camiloVargasTechnaid/techstim-hardware/3DMODELS/EXG.0B.304.HLN/EPG.0B.306.HLN.stp

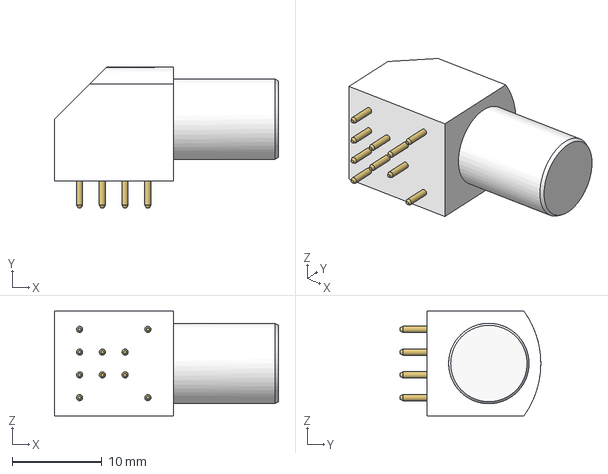
[picture p1: CAD file, 2024-04-24]
3DMODELS/EXG.0B.304.HLN/EPG.0B.306.HLN.stp
25.0 x 15.7 x 11.7 mm
