camiloVargasTechnaid/techstim-hardware/3DMODELS/EXG.1B.306.LLNZ/EXP.1S.306.HLNS.stp

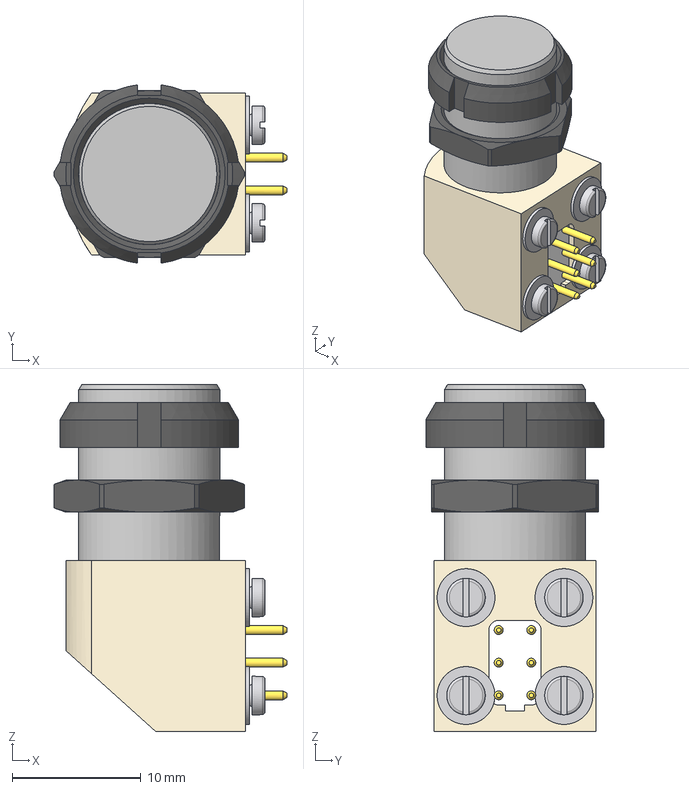
[picture p2: CAD file, 2024-05-03]
3DMODELS/EXG.1B.306.LLNZ/EXP.1S.306.HLNS.stp
18.1 x 13.9 x 27.0 mm
EXP.1S.306.HLNS_PART1
EXP.1S.306.HLNS_PART2
EXP.1S.306.HLNS_PART3
