camiloVargasTechnaid/techstim-hardware/3DMODELS/EXP.0S.302.HLNS/EXP.0S.302.HLNS.stp

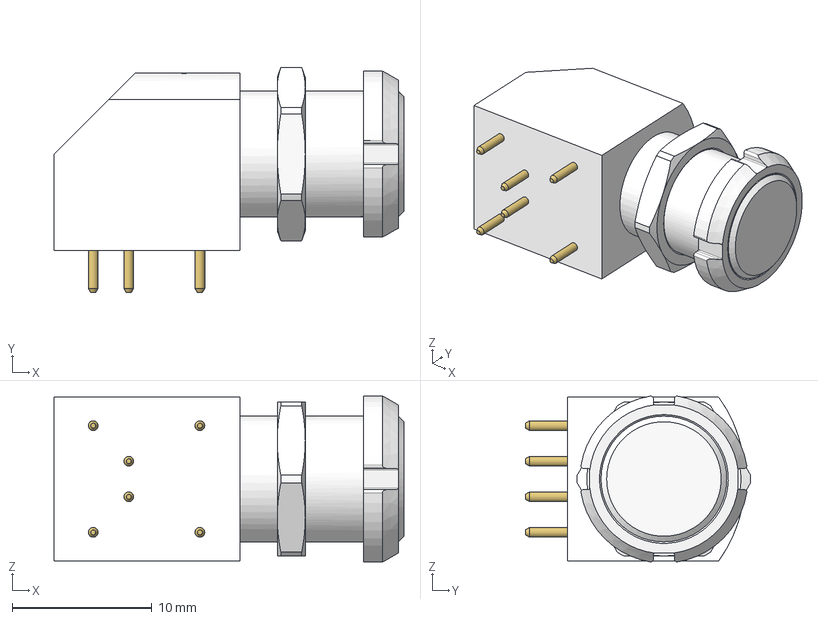
[picture p3: CAD file, 2024-05-03]
3DMODELS/EXP.0S.302.HLNS/EXP.0S.302.HLNS.stp
25.0 x 16.1 x 11.8 mm
EXP.0S.302.HLNS_PART1
EXP.0S.302.HLNS_PART2
EXP.0S.302.HLNS_PART3
