camiloVargasTechnaid/techstim-hardware/3DMODELS/HV2701FG-G/HV2701FG-G.stp

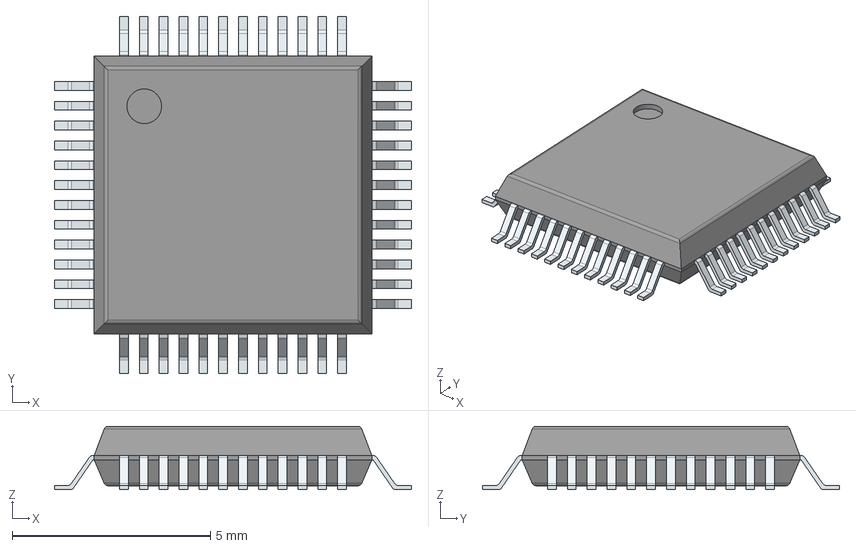
[picture p4: CAD file, 2024-04-23]
3DMODELS/HV2701FG-G/HV2701FG-G.stp
9.00 x 9.00 x 1.60 mm
PinsArrayLR
PinsArrayTB
