camiloVargasTechnaid/techstim-hardware/3DMODELS/INA149AMDREP/INA149AMDREP.stp

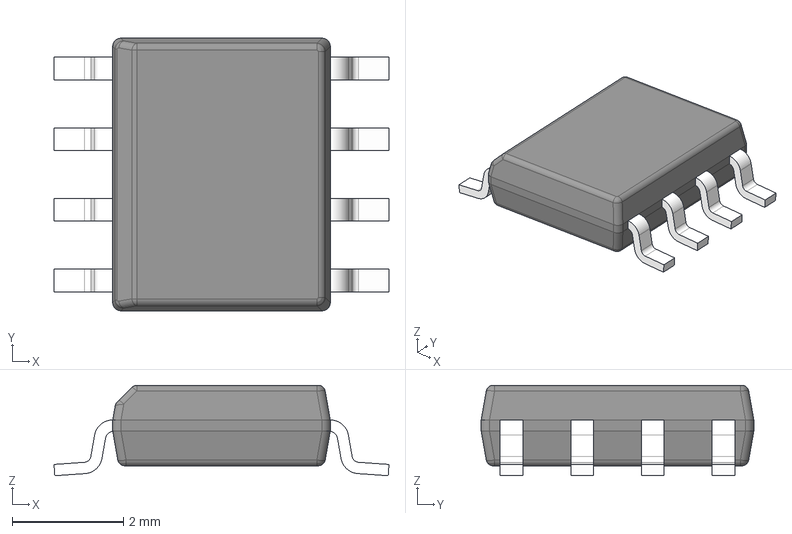
[picture p5: CAD file, 2024-04-19]
3DMODELS/INA149AMDREP/INA149AMDREP.stp
6.02 x 4.90 x 1.63 mm
BODY-SO
LEAD-D0008A x 8
