camiloVargasTechnaid/techstim-hardware/3DMODELS/jack-2_35mm-smt-for-tens/jack-2_35mm-smt-for-tens.step

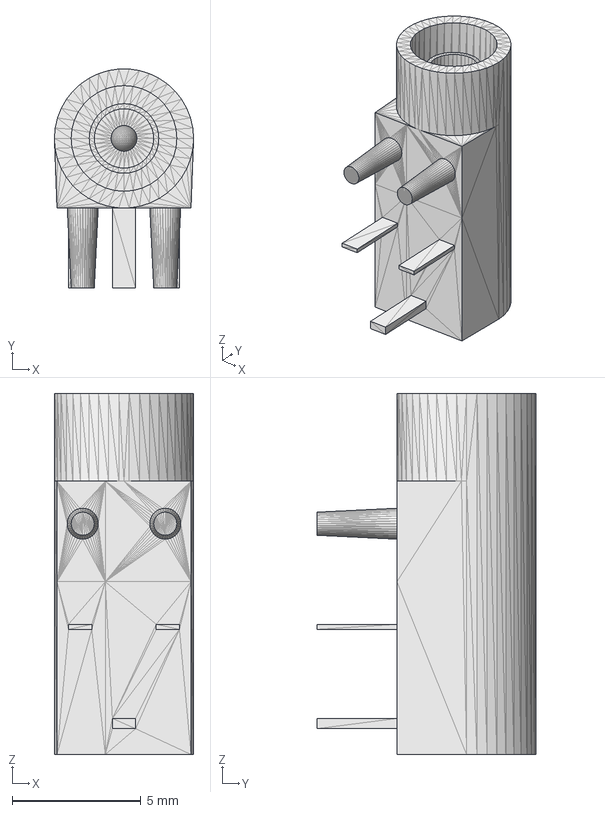
[picture p6: CAD file, 2024-07-05]
3DMODELS/jack-2_35mm-smt-for-tens/jack-2_35mm-smt-for-tens.step
5.40 x 8.49 x 14.0 mm
