camiloVargasTechnaid/techstim-hardware/3DMODELS/PA78DK/PA78DK.step

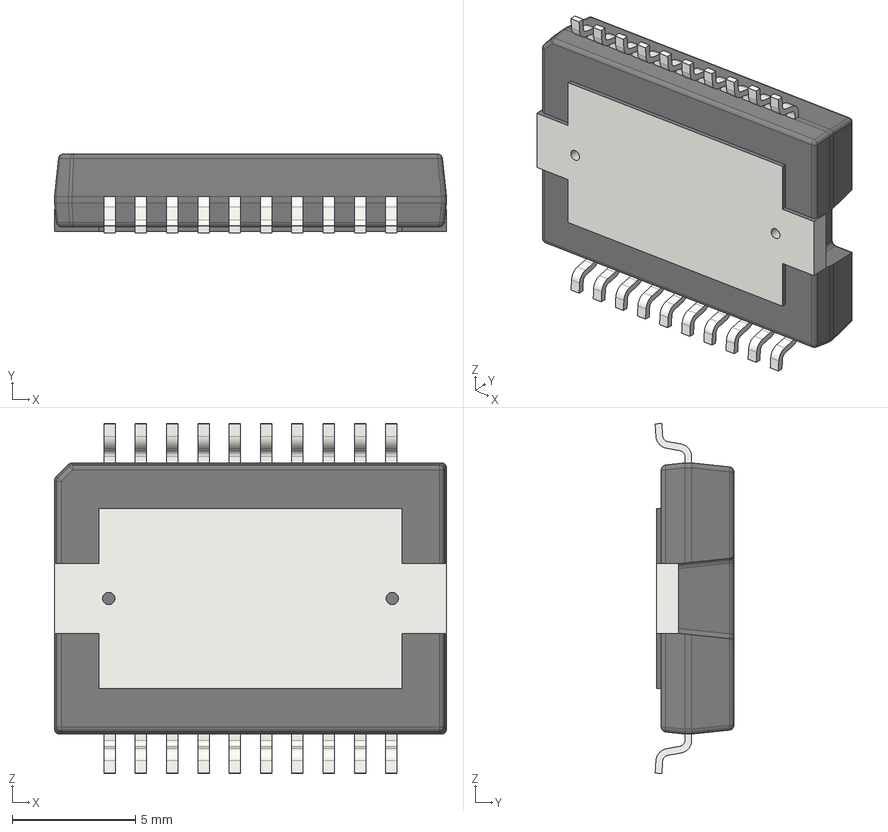
[picture p7: CAD file, 2024-05-03]
3DMODELS/PA78DK/PA78DK.step
15.9 x 3.20 x 14.2 mm
