camiloVargasTechnaid/techstim-hardware/3DMODELS/SN6501DBVR/SN6501DBVR.stp

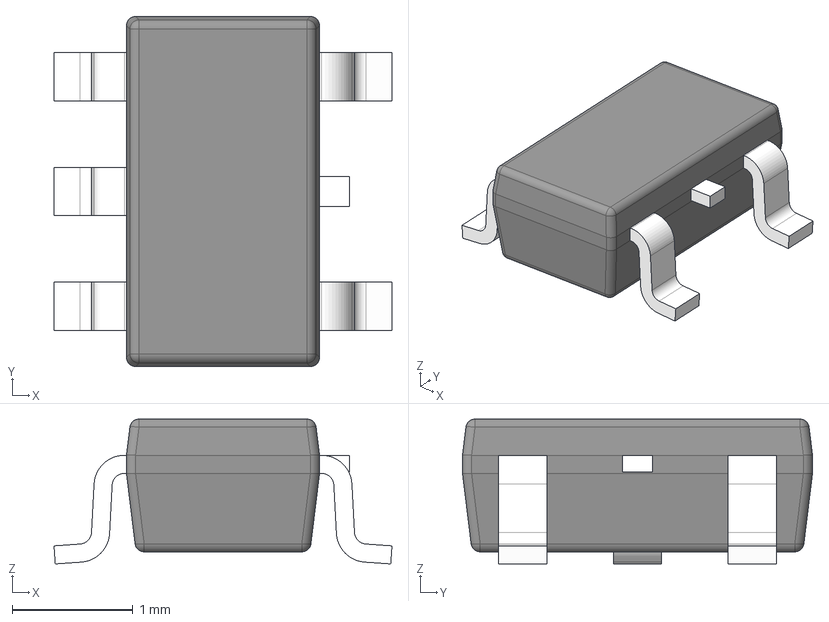
[picture p8: CAD file, 2024-04-19]
3DMODELS/SN6501DBVR/SN6501DBVR.stp
2.80 x 2.90 x 1.20 mm
BODY-SOT
LEAD-SOT x 5
LEAD-DUMMY
