camiloVargasTechnaid/techstim-hardware/3DMODELS/EXG.0B.304.HLN/XBA.00.304.HLNZ.stp

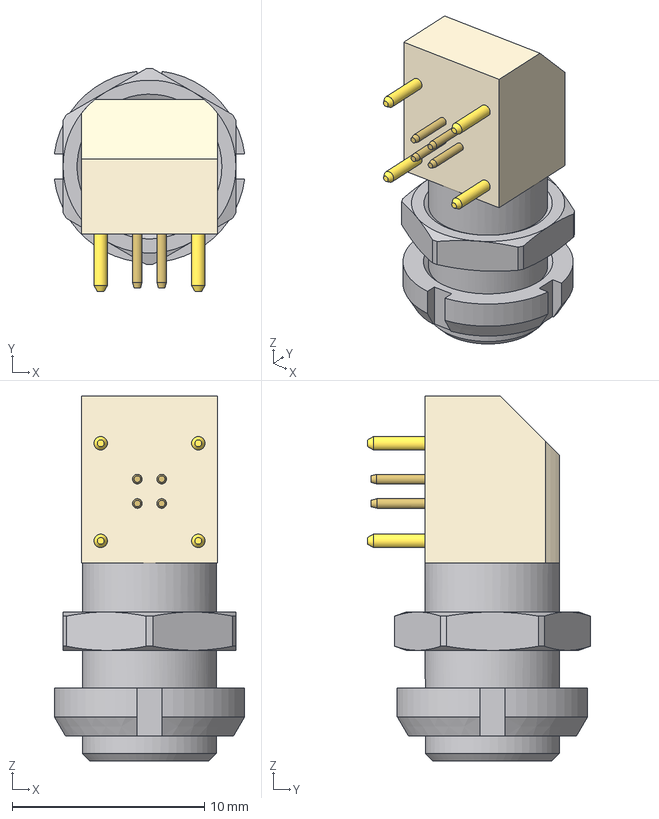
[picture p9: CAD file, 2024-04-24]
3DMODELS/EXG.0B.304.HLN/XBA.00.304.HLNZ.stp
9.92 x 11.6 x 19.0 mm
XBA.00.304.HLNZ_PART1
XBA.00.304.HLNZ_PART2
XBA.00.304.HLNZ_PART3
