camiloVargasTechnaid/techstim-hardware/3DMODELS/EXG.0B.304.HLN/EXP.1S.304.HLN.stp

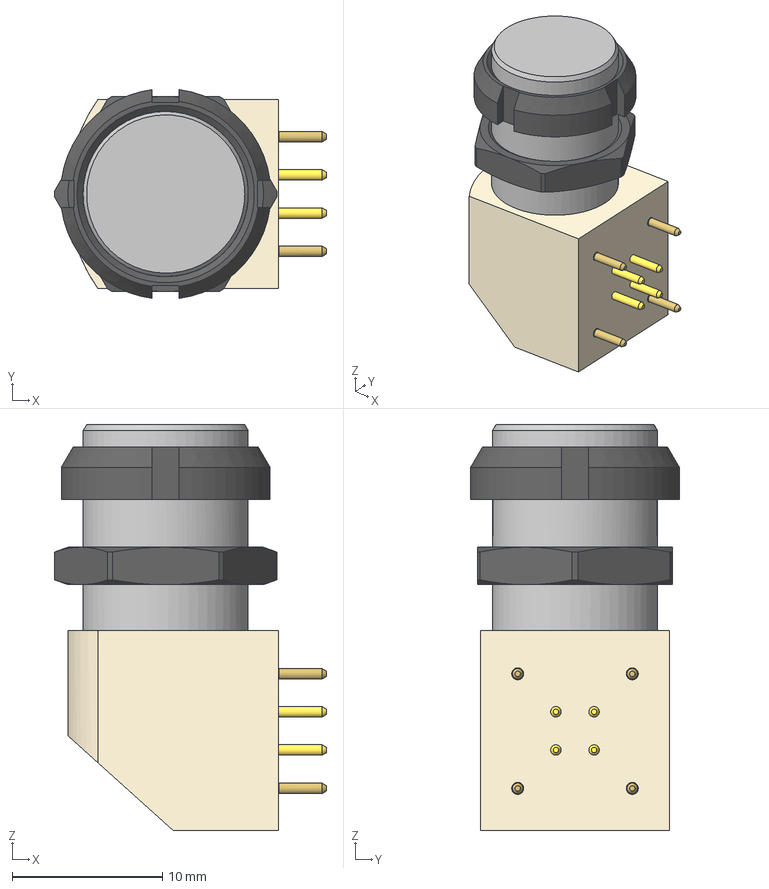
[picture p10: CAD file, 2024-04-24]
3DMODELS/EXG.0B.304.HLN/EXP.1S.304.HLN.stp
18.1 x 13.9 x 27.0 mm
EXP.1S.304.HLN_PART1
EXP.1S.304.HLN_PART2
EXP.1S.304.HLN_PART3
