camiloVargasTechnaid/techstim-hardware/3DMODELS/760390014/760390014_color.stp

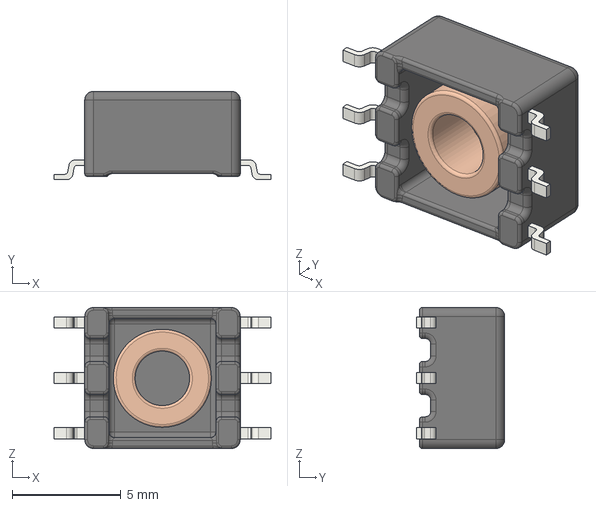
[picture p11: CAD file, 2024-05-03]
3DMODELS/760390014/760390014_color.stp
9.96 x 4.06 x 6.48 mm
