camiloVargasTechnaid/techstim-hardware/3DMODELS/DAC63204RTERQ1/DAC63204RTERQ1.stp

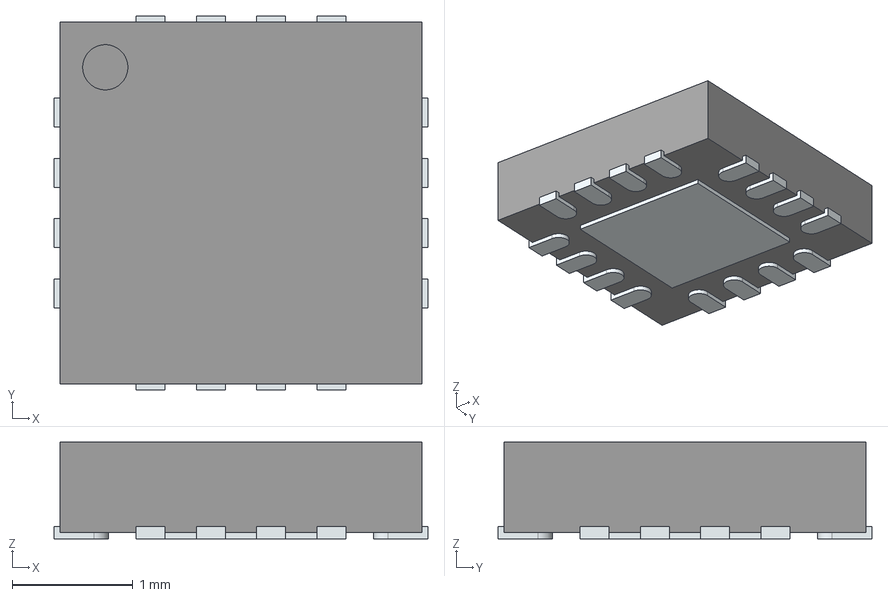
[picture p12: CAD file, 2024-04-23]
3DMODELS/DAC63204RTERQ1/DAC63204RTERQ1.stp
3.10 x 3.10 x 0.8 mm
ThermalPin
PinsArrayLR
PinsArrayTB
