camiloVargasTechnaid/techstim-hardware/3DMODELS/ISO7640FMDWR/ISO7640FMDWR.stp

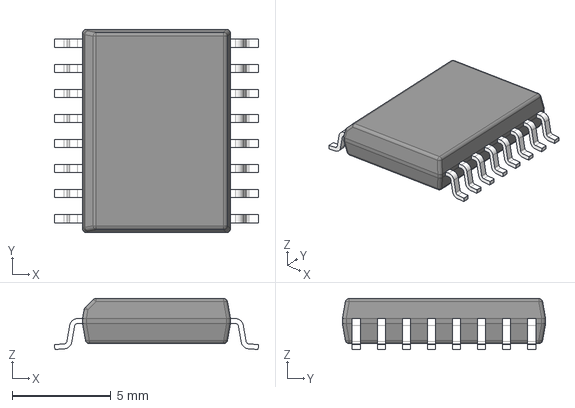
[picture p13: CAD file, 2024-05-03]
3DMODELS/ISO7640FMDWR/ISO7640FMDWR.stp
10.3 x 10.3 x 2.59 mm
BODY-SOIC
LEAD-DW0016 x 16
