camiloVargasTechnaid/techstim-hardware/3DMODELS/LD39050PU33R/LD39050PU33R.stp

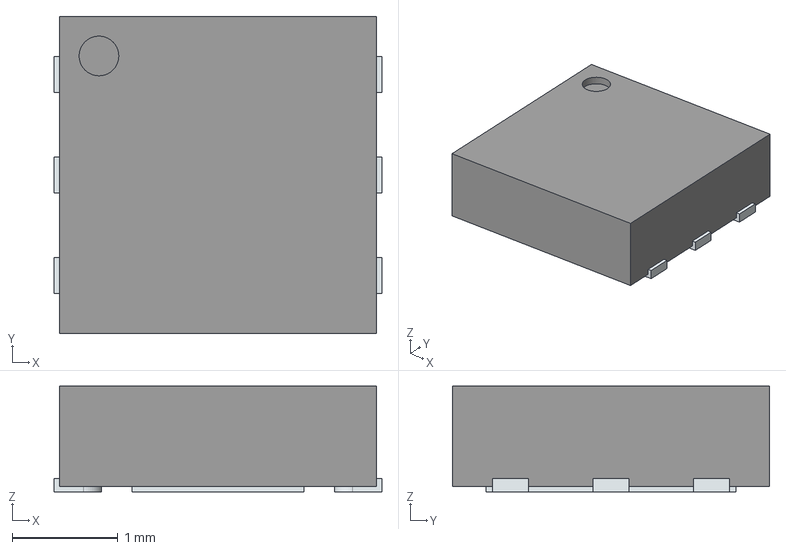
[picture p14: CAD file, 2024-04-19]
3DMODELS/LD39050PU33R/LD39050PU33R.stp
3.10 x 3.00 x 1.00 mm
ThermalPin
PinsArrayLR
