camiloVargasTechnaid/techstim-hardware/3DMODELS/MAX14802CCM+/MAX14802CCM+.stp

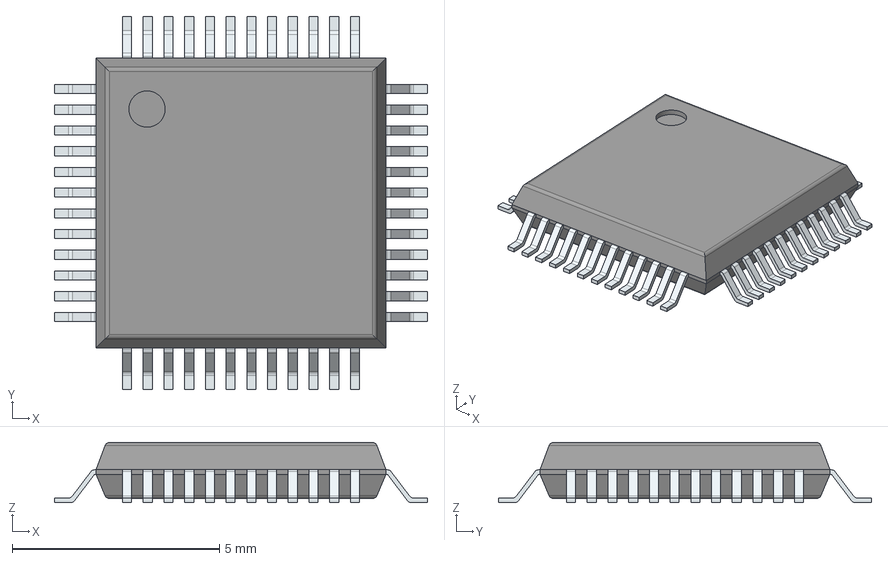
[picture p15: CAD file, 2024-04-23]
3DMODELS/MAX14802CCM+/MAX14802CCM+.stp
9.00 x 9.00 x 1.45 mm
PinsArrayLR
PinsArrayTB
