camiloVargasTechnaid/techstim-hardware/3DMODELS/REF35500QDBVR/REF35500QDBVR.stp

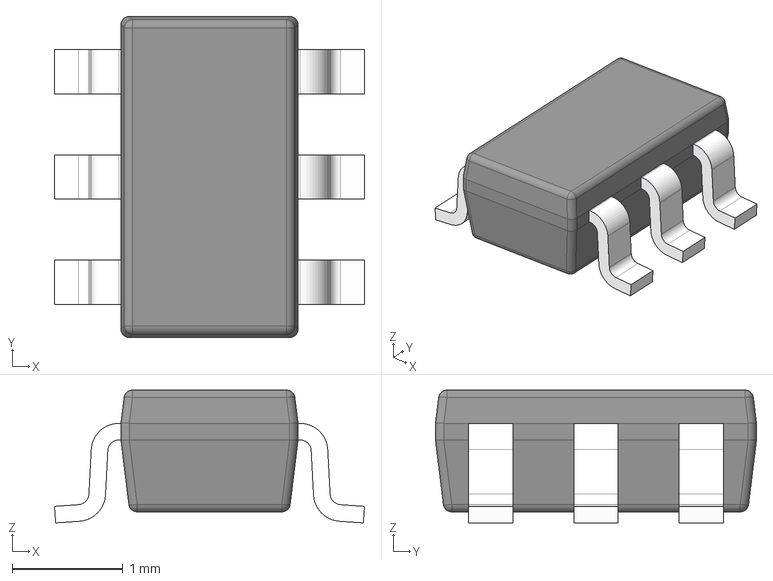
[picture p16: CAD file, 2024-04-24]
3DMODELS/REF35500QDBVR/REF35500QDBVR.stp
2.80 x 2.90 x 1.20 mm
BODY-SOT
LEAD-SOT x 6
