camiloVargasTechnaid/techstim-hardware/(list of files, cad)

Other CAD files:
3DMODELS/PA78DK/PA79DK_color.stp
3DMODELS/ISO7641FMDWR/ISO7641FMDWR.stp
3DMODELS/760390014/760390014.stp
3DMODELS/PA78DK/PA78DK.stp
