camiloVargasTechnaid/techstim-hardware/(commit log)

2024-04-17 chore: first commit
    [techstim-hardware.kicad_pcb, techstim-hardware.kicad_sch]
2024-04-17 fix: replace uC STM32F103C8T6 to STM32F103CBT6 (128 kB version) layout
    [techstim-hardware.kicad_sch]
2024-04-18 feat: adding power, reset, clock, and usb components
    [techstim-hardware.kicad_sch]
2024-04-19 build: adding 3DModels for LDO, DAC, and OPA
    [INA149AMDREP.stp, LD39050PU33R.stp, OPA140AIDBVT.stp]
2024-04-19 feat: adding LDO support
    [techstim-hardware.kicad_sch]
2024-04-22 feat: adding correct footprint for all the components
    [techstim-hardware.kicad_pcb, techstim-hardware.kicad_sch]
2024-04-23 feat: adding 3DModels for isolation + DAC stage
    [760390014.stp, DAC63204RTERQ1.stp, ISO7641FMDWR.stp, SN6501DBVR.stp]
2024-04-23 feat: creating isolation+ DAC sch page
    [isolation_dac.kicad_sch]
2024-04-23 fix: isolation+dac page is connect with main page
    [techstim-hardware.kicad_pcb, techstim-hardware.kicad_sch]
2024-04-23 feat: adding page to set HV2701
    [hv_switch_hv2701.kicad_sch]
2024-04-23 refactor: som enames and label in HV_SW
    [hv_switch.kicad_sch]
2024-04-23 feat: adding libraries for HV2701 and MAX14802
    [HV2701FG-G.stp, MAX14802CCM+.stp]
2024-04-23 fix: adding isolation and HV pages
    [isolation_dac.kicad_sch, techstim-hardware.kicad_pcb, techstim-hardware.kicad_sch]
2024-04-24 feat: create HV_OPA sheet
    [techstim-hardware.kicad_sch]
2024-04-24 feat: adding isolation_dac sheet
    [hv_opa.kicad_sch, isolation_dac.kicad_sch]
2024-04-24 fix: adding 3DModels
    [EPG.0B.306.HLN.stp, EXP.1S.304.HLN.stp, PA78DK.stp, PA79DK_color.stp, REF35500QDBVR.stp, XBA.00.304.HLNZ.stp]
2024-04-24 feat: update pcb design
    [techstim-hardware.kicad_pcb]
2024-04-30 fix: update PA78DK 3dmodel
    [PA78DK.step]
2024-04-30 feat: create 3Dmodel for PCB
2024-04-30 fix: duplicate HV SWITCH page for HV2701 and MAX14802
    [hv_switch.kicad_sch, hv_switch_hv2701.kicad_sch]
2024-04-30 fix: resistors and capacitors values tested in LTSPICE for HV OPA page
    [hv_opa.kicad_sch]
2024-04-30 fix: update main page
    [isolation_dac.kicad_sch, techstim-hardware.kicad_pcb, techstim-hardware.kicad_sch]
2024-04-30 fix: using REF4096 for 12 bits
    [isolation_dac.kicad_sch]
2024-04-30 fix: using 4.096V reference instead of 5V
    [hv_opa.kicad_sch]
2024-04-30 refactor: adding info for tolerance in capacitors for HVOPA
    [hv_opa.kicad_sch]
2024-05-03 feat: replace LEMO 4 pin to LEMO 6 pin to obtain +/-5V power source
    [EXP.1S.306.HLNS.stp]
2024-05-03 feat: adding isolation to HVSW page
    [techstim-hardware.kicad_pcb]
2024-05-03 fix: replacement of ISO7641 with ISO7640
    [hv_switch.kicad_sch, hv_switch_hv2701.kicad_sch, isolation_dac.kicad_sch]
2024-05-03 feat: adding support for ISO7640 IC and its 3dmodel
    [ISO7640FMDWR.stp, PA78DK.step]
2024-05-03 fix: bad 3dmodel for 760390014
    [760390014.stp, 760390014_color.stp]
2024-05-03 feat: adding 3dmodel for LEMO2 connector
    [EXP.0S.302.HLNS.stp]
2024-05-03 fix: update PCB with last 3dmodels and ICs (ISO7640, GNDISO)
    [hv_opa.kicad_sch, hv_switch.kicad_sch, hv_switch_hv2701.kicad_sch, isolation_dac.kicad_sch, techstim-hardware.kicad_pcb, techstim-hardware.kicad_sch]
2024-05-06 refactor: update main page
    [techstim-hardware.kicad_pcb, techstim-hardware.kicad_sch]
2024-05-07 docs: update S1L, S1N, MFP, MFN
    [hv_switch.kicad_sch, isolation_dac.kicad_sch, techstim-hardware.kicad_sch]
2024-05-08 chore: adding technaid_logo symbol and footprint
2024-05-08 chore: adding footprint for DC2.35 mm (040TK-18030602)
2024-05-08 fix: adding connector to select communication between HV_Switches
    [hv_switch.kicad_sch, hv_switch_hv2701.kicad_sch, techstim-hardware.kicad_pcb, techstim-hardware.kicad_sch]
2024-05-20 docs: adding Note for choose R_pull_up over I2C pins
    [isolation_dac.kicad_sch, techstim-hardware.kicad_sch]
2024-07-04 fix: update Rcl with stock in supplier
    [hv_opa.kicad_sch]
2024-07-04 ops: adding SP1# field and add all the info for each component
    [hv_opa.kicad_sch, hv_switch.kicad_sch, hv_switch_hv2701.kicad_sch]
2024-07-05 feat: adding goochain jack 2.35 mm to design
    [isolation_dac.kicad_sch, jack-2_35mm-smt-for-tens.step, techstim-hardware.kicad_pcb, techstim-hardware.kicad_sch]
2024-08-12 fix: adding esd device in output hv2
    [hv_switch_hv2701.kicad_sch, techstim-hardware.kicad_sch]
2024-08-12 docs: update BOM
    [hv_switch.kicad_sch, isolation_dac.kicad_sch]
2024-08-15 fix: update names for IC components
    [hv_opa.kicad_sch, hv_switch.kicad_sch, hv_switch_hv2701.kicad_sch, isolation_dac.kicad_sch, techstim-hardware.kicad_pcb, techstim-hardware.kicad_sch]
