camiloVargasTechnaid/techstim-hardware/(notices)

Notices in the files:
3DMODELS/EXG.1B.306.LLNZ/EXP.1S.306.HLNS.stp:
author */ ('License CC BY-ND 4.0'),
